jack-greenberg/2sb/3d/USB4520-03-0-A.stp

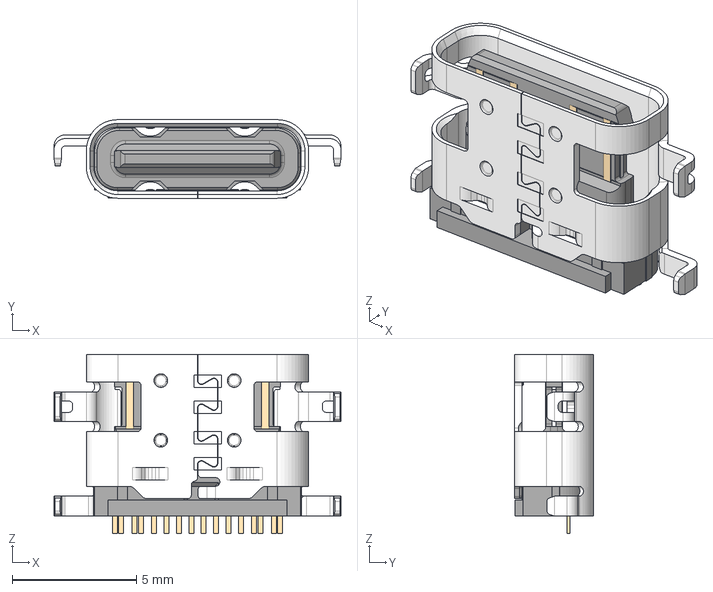
[picture p1: CAD file, 2023-04-24]
3d/USB4520-03-0-A.stp
11.5 x 3.16 x 7.20 mm
USB4520-03-0-A_PART2
USB4520-03-0-A_PART1
