jack-greenberg/2sb/3d/RWB0012A.stp

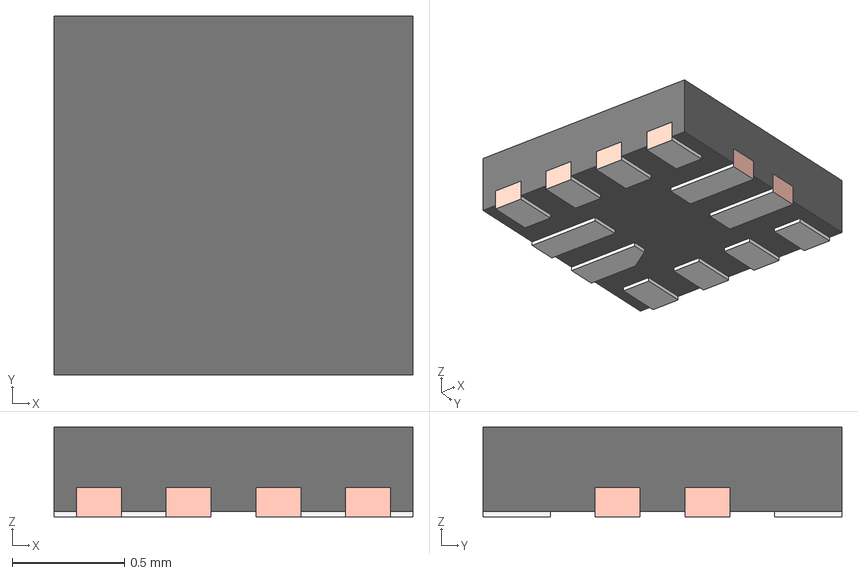
[picture p2: CAD file, 2023-03-13]
3d/RWB0012A.stp
1.60 x 1.60 x 0.4 mm
FRAME-RWB0012A
BODY-QFN
