jack-greenberg/2sb/3d/SQFN24_4X4MC_MCH.step

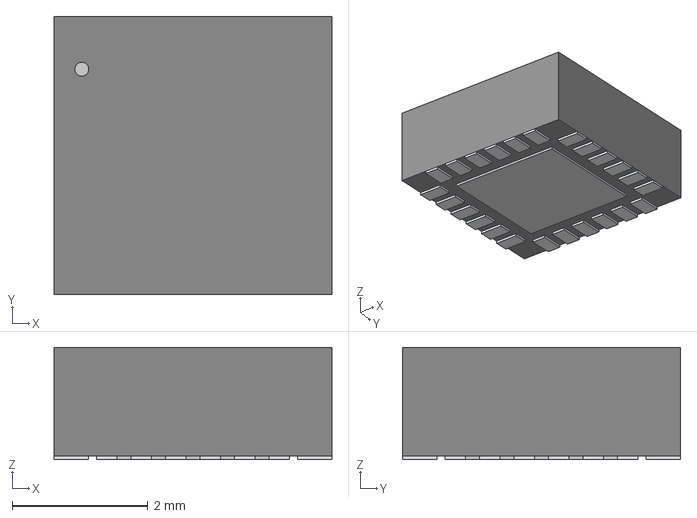
[picture p3: CAD file, 2023-03-03]
3d/SQFN24_4X4MC_MCH.step
4.09 x 4.09 x 1.65 mm
