jack-greenberg/2sb/3d/TMLF-6_MT_MCH.step

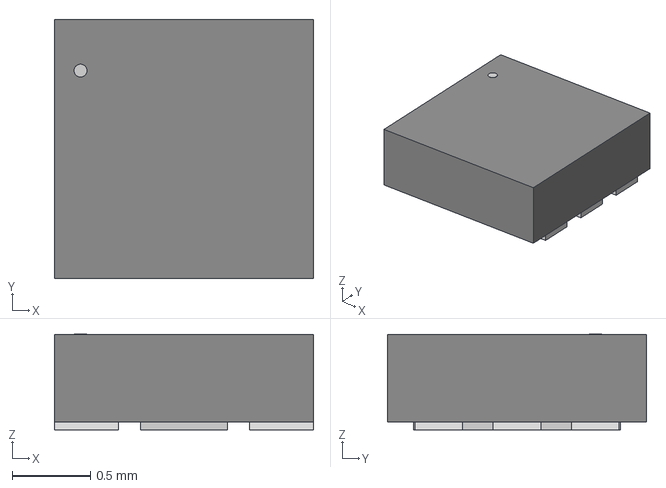
[picture p4: CAD file, 2023-03-03]
3d/TMLF-6_MT_MCH.step
1.65 x 1.65 x 0.612 mm
