jack-greenberg/2sb/3d/ABM12W-24.0000MHZ-6-D1X-T3.step

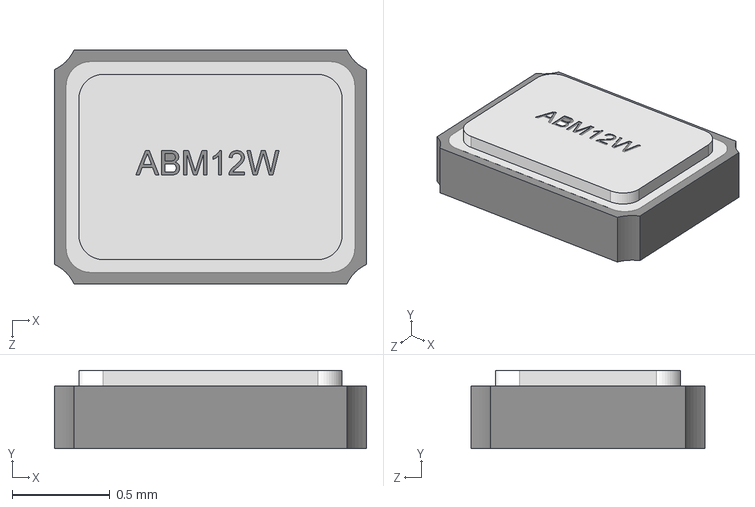
[picture p5: CAD file, 2023-03-03]
3d/ABM12W-24.0000MHZ-6-D1X-T3.step
1.60 x 0.4 x 1.20 mm
