jack-greenberg/2sb/3d/QFN36_6X6MC_MCH.step

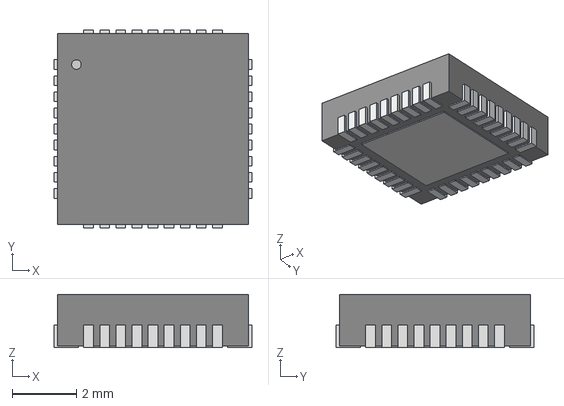
[picture p6: CAD file, 2023-03-03]
3d/QFN36_6X6MC_MCH.step
6.15 x 6.15 x 1.65 mm
