jack-greenberg/2sb/3d/216990-0002.stp

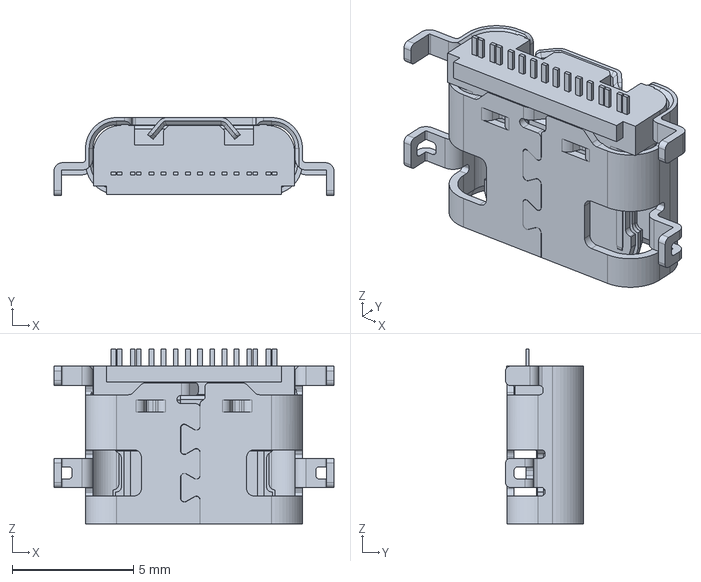
[picture p7: CAD file, 2023-03-03]
3d/216990-0002.stp
11.5 x 3.21 x 7.20 mm
