jack-greenberg/2sb/3d/1054440001.stp

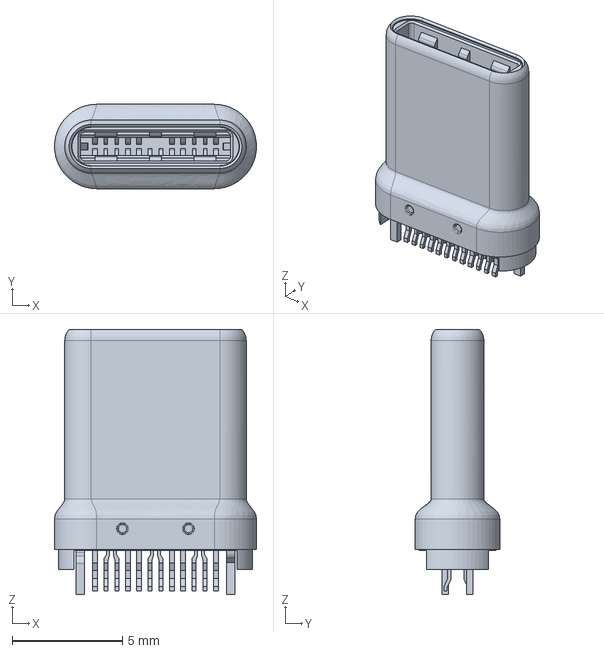
[picture p8: CAD file, 2023-03-03]
3d/1054440001.stp
9.18 x 3.84 x 12.0 mm
