jack-greenberg/2sb/3d/105455-0101.stp

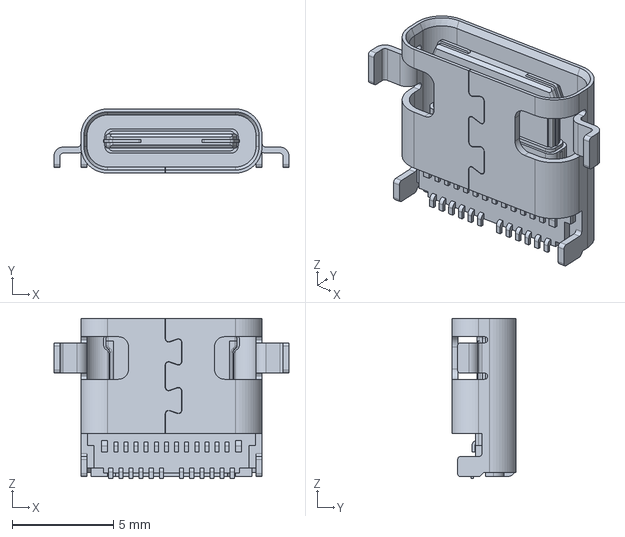
[picture p9: CAD file, 2023-03-03]
3d/105455-0101.stp
11.6 x 3.16 x 7.90 mm
