jack-greenberg/2sb/(list of files, cad)

Other CAD files:
3d/216990-0003.stp
