jack-greenberg/2sb/2usbc.kicad_pcb

## KiCad design 2usbc.kicad_pcb (2023-04-24)

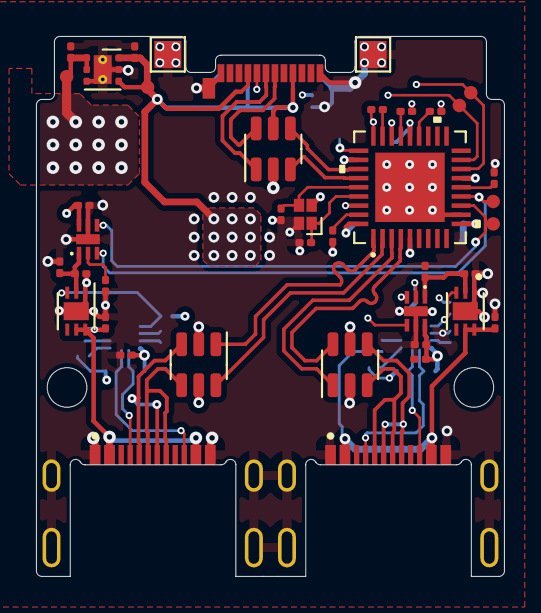
[picture p10: board 2usbc.kicad_pcb from above]

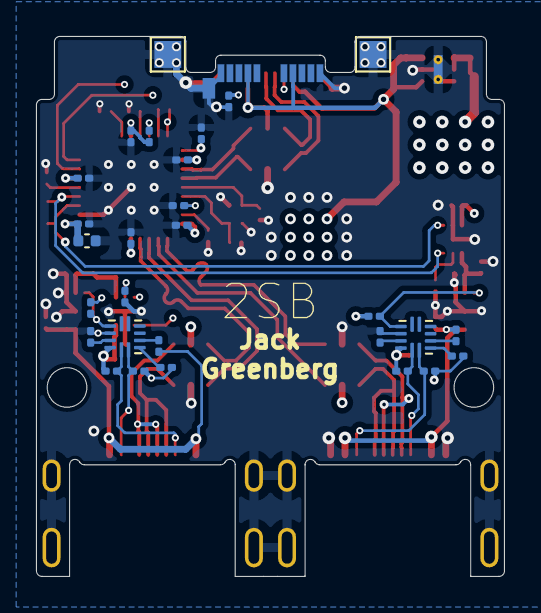
[picture p11: board 2usbc.kicad_pcb from below]

Board: 4 copper layers, 26.0 x 30.0 mm, 71 parts (28 on the bottom side), 48 nets.

Parts:
C101, C304, C404: 1uF; C_0201_0603Metric
C102: 2.2uF; C_0201_0603Metric
C201, C203, C205, C206, C207, C208: 10nF; C_0201_0603Metric
C202, C204: 6pF; C_0201_0603Metric
C209, C211, C301, C302, C305, C401, C402, C405: 0.1uF; C_0201_0603Metric
C210: 2uF; C_0402_1005Metric
C303, C403: 10uF; C_0201_0603Metric
H101, H102: MountingHole; MountingHole_2.2mm_M2
J101: USB_C_Plug_USB2.0; USB_C_Plug_Molex_105444
J102, J103: USB_C_Receptacle_USB2.0; USB4520
R101: 5.1K; R_0201_0603Metric
R201, R204, R205, R206, R207, R305, R405: 100K; R_0201_0603Metric
R208: 12K; R_0201_0603Metric
R301, R401: 330R; R_0201_0603Metric
R302, R303, R402, R403: 56K; R_0201_0603Metric
R304, R404: 900K; R_0201_0603Metric
R306, R406: 10K; R_0201_0603Metric
R307, R407: 10k; R_0201_0603Metric
TP101, TP102, TP103, TP104: TestPoint; TestPoint_Pad_1.5x1.5mm
TP105, TP106, TP301, TP302, TP401, TP402: TestPoint; TestPoint_MD
U101: TLV76733DRVx; WSON-6-1EP_2x2mm_P0.65mm_EP1x1.6mm_ThermalVias
U102, U301, U401: USBLC6-2SC6; SOT-23-6
U201: USB2512B; USB2512-AEZG
U302, U402: TMLF-6_MT_MCH; MIC2097-1YMT-TR
U303, U403: TUSB320; Texas_X2QFN-12_1.6x1.6mm_P0.4mm
U304, U404: AP2161W; SON50P181X201X60-7N
Y201: 24MHz; XTAL_ABM12W-24.0000MHZ-6-D1X-T3

Connections:
+3V3: C102.1, C201.1, C203.1, C205.1, C206.1, C207.1, C208.1, C210.1, R201.1, R207.1, TP106.1, U101.1 (OUT), U101.2 (SNS), U201.5 (VDDA33), U201.10 (VDDA33), U201.15 (VDD33), U201.23 (VDD33), U201.27 (VBUS_DET), U201.29 (VDDA33), U201.36 (VDDA33)
/HOST_CC: J101.A5 (CC), R101.1
/Hub IC/P1_ENABLE: TP301.1, U201.12 (PRTPWR1/BC_EN1), U302.4 (ENABLE)
/Hub IC/P1_OVER_CURRENT: TP302.1, U201.13 (OCS_N1), U302.3 (~FAULT)
/Hub IC/P2_ENABLE: TP401.1, U201.16 (PRTPWR2/BC_EN2), U402.4 (ENABLE)
/Hub IC/P2_OVER_CURRENT: TP402.1, U201.17 (OCS_N2), U402.3 (~FAULT)
/Hub IC/USB_P1_DN: U201.1 (USBDM_DN1/PRT_DIS_M1), U301.1 (I/O1)
/Hub IC/USB_P1_DP: U201.2 (USBDP_DN1/PRT_DIS_P1), U301.6 (I/O1)
/Hub IC/USB_P2_DN: U201.3 (USBDM_DN2/PRT_DIS_M2), U401.1 (I/O1)
/Hub IC/USB_P2_DP: U201.4 (USBDP_DN2/PRT_DIS_P2), U401.6 (I/O1)
/Hub IC/~RESET: R201.2, U201.26 (RESET_N)
/Output Stage 1/ID: R306.2, U303.9 (ID), U304.3 (~EN)
/Output Stage 1/ILIMIT: R301.1, U302.2 (ILIMIT)
/Output Stage 1/OUT_USB_DN: J102.A7 (D-), J102.B7 (D-), U301.3 (I/O2)
/Output Stage 1/OUT_USB_DP: J102.A6 (D+), J102.B6 (D+), U301.4 (I/O2)
/Output Stage 1/PORT: R307.2, U303.3 (PORT)
/Output Stage 1/VBUS_DET: R304.1, U303.4 (VBUS_DET)
/Output Stage 1/VOUT_I_LIM: C302.2, C303.2, U302.1 (VOUT), U304.2 (IN)
/Output Stage 1/~EN: R305.1, U303.11 (~EN)
/Output Stage 2/ID: R406.2, U403.9 (ID), U404.3 (~EN)
/Output Stage 2/ILIMIT: R401.1, U402.2 (ILIMIT)
/Output Stage 2/OUT_USB_DN: J103.A7 (D-), J103.B7 (D-), U401.3 (I/O2)
/Output Stage 2/OUT_USB_DP: J103.A6 (D+), J103.B6 (D+), U401.4 (I/O2)
/Output Stage 2/PORT: R407.2, U403.3 (PORT)
/Output Stage 2/VBUS_DET: R404.1, U403.4 (VBUS_DET)
/Output Stage 2/VOUT_I_LIM: C402.2, C403.2, U402.1 (VOUT), U404.2 (IN)
/Output Stage 2/~EN: R405.1, U403.11 (~EN)
/P1_CC1: J102.A5 (CC1), R302.1, U303.1 (CC1)
/P1_CC2: J102.B5 (CC2), R303.1, U303.2 (CC2)
/P1_VBUS: C304.2, J102.A4 (VBUS), J102.B4 (VBUS), R304.2, U304.5 (OUT), U304.6 (OUT)
/P2_CC1: J103.A5 (CC1), R402.1, U403.1 (CC1)
/P2_CC2: J103.B5 (CC2), R403.1, U403.2 (CC2)
/P2_VBUS: C404.2, J103.A4 (VBUS), J103.B4 (VBUS), R404.2, U404.5 (OUT), U404.6 (OUT)
/USB_HOST_DN: J101.A7 (D-), U102.6 (I/O1)
/USB_HOST_DP: J101.A6 (D+), U102.1 (I/O1)
/USB_PROTECT_HOST_DN: U102.4 (I/O2), U201.30 (USBDM_UP)
/USB_PROTECT_HOST_DP: U102.3 (I/O2), U201.31 (USBDP_UP)
GND: C101.2, C102.2, C201.2, C202.2, C203.2, C204.2, C205.2, C206.2, C207.2, C208.2, C209.2, C210.2, C211.2, C301.1, C302.1, C303.1, C304.1, C305.1, C401.1, C402.1, C403.1, C404.1, C405.1, J101.A1 (GND), J101.A12 (GND), J101.B1 (GND), J101.B12 (GND), J101.S1 (SHIELD), J102.A1 (GND), J102.B1 (GND), J102.S1 (SHIELD), J103.A1 (GND), J103.B1 (GND), J103.S1 (SHIELD), R101.2, R204.2, R205.2, R206.2, R208.2, R301.2, R305.2, R401.2, R405.2, TP101.1, TP102.1, TP103.1, TP104.1, U101.3 (GND), U101.5 (GND), U101.7 (PAD), U102.2 (GND), U201.11 (TEST), U201.37 (EPAD), U301.2 (GND), U302.5 (GND), U302.7 (EPAD), U303.10 (GND), U304.1 (GND), U304.7 (PAD), U401.2 (GND), U402.5 (GND), U402.7 (EPAD), U403.10 (GND), U404.1 (GND), U404.7 (PAD), Y201.2, Y201.4
unnamed: C209.1, U201.14 (CRFILT)
unnamed: R207.2, U201.25 (HS_IND/CFG_SEL1)
unnamed: C211.1, U201.34 (PLLFILT)
unnamed: R208.1, U201.35 (RBIAS)
unnamed: R206.1, U201.24 (SCL/SMBCLK/CFG_SEL0)
unnamed: R204.1, U201.22 (SDA/SMBDATA/NON_REM1)
unnamed: R205.1, U201.28 (SUSP_IND/LOCAL_PWR/NON_REM0)
unnamed: C202.1, U201.33 (XTALIN/CLKIN), Y201.1
unnamed: C204.1, U201.32 (XTALOUT), Y201.3
VBUS: C101.1, C301.2, C305.2, C401.2, C405.2, J101.A4 (VBUS), J101.A9 (VBUS), J101.B4 (VBUS), J101.B9 (VBUS), R302.2, R303.2, R306.1, R307.1, R402.2, R403.2, R406.1, R407.1, TP105.1, U101.4 (EN), U101.6 (IN), U102.5 (VBUS), U301.5 (VBUS), U302.6 (VIN), U303.12 (VDD), U401.5 (VBUS), U402.6 (VIN), U403.12 (VDD)
