jack-greenberg/2sb/(commit log)

2023-03-03 Update CC resistors with feedback
    [2usbc.kicad_pcb, 2usbc.kicad_sch, output_1.kicad_sch]
2023-03-10 Add power switch ic and channel config ic
    [2usbc.kicad_pcb, 2usbc.kicad_sch, output_1.kicad_sch]
2023-03-13 Layout checkpoint
    [2usbc.kicad_pcb, 2usbc.kicad_sch, RWB0012A.stp, output_1.kicad_sch]
2023-03-13 Update layout to be a bit more symmetrical
    [2usbc.kicad_pcb]
2023-04-24 Update schematic with feedback
    [2usbc.kicad_pcb, 2usbc.kicad_sch, USB4520-03-0-A.stp, hub.kicad_sch, output_1.kicad_sch]
2023-05-30 Add schematic PDF
