jack-greenberg/2sb/(notices)

Notices in the files:
2usbc.sch:
This work is licensed under a Creative Commons Attribution 4.0 International License
3d/USB4520-03-0-A.stp:
author */ ('License CC BY-ND 4.0'),
